longhitoshi2005/Autonomous-Waiter-Robot-Based-on-ROS-2-Jazzy-and-Edge-Computing/ros2_ws/frames_2026-04-19_21.30.28.pdf

view_frames Result

Recorded at time: 1776609028.4618711

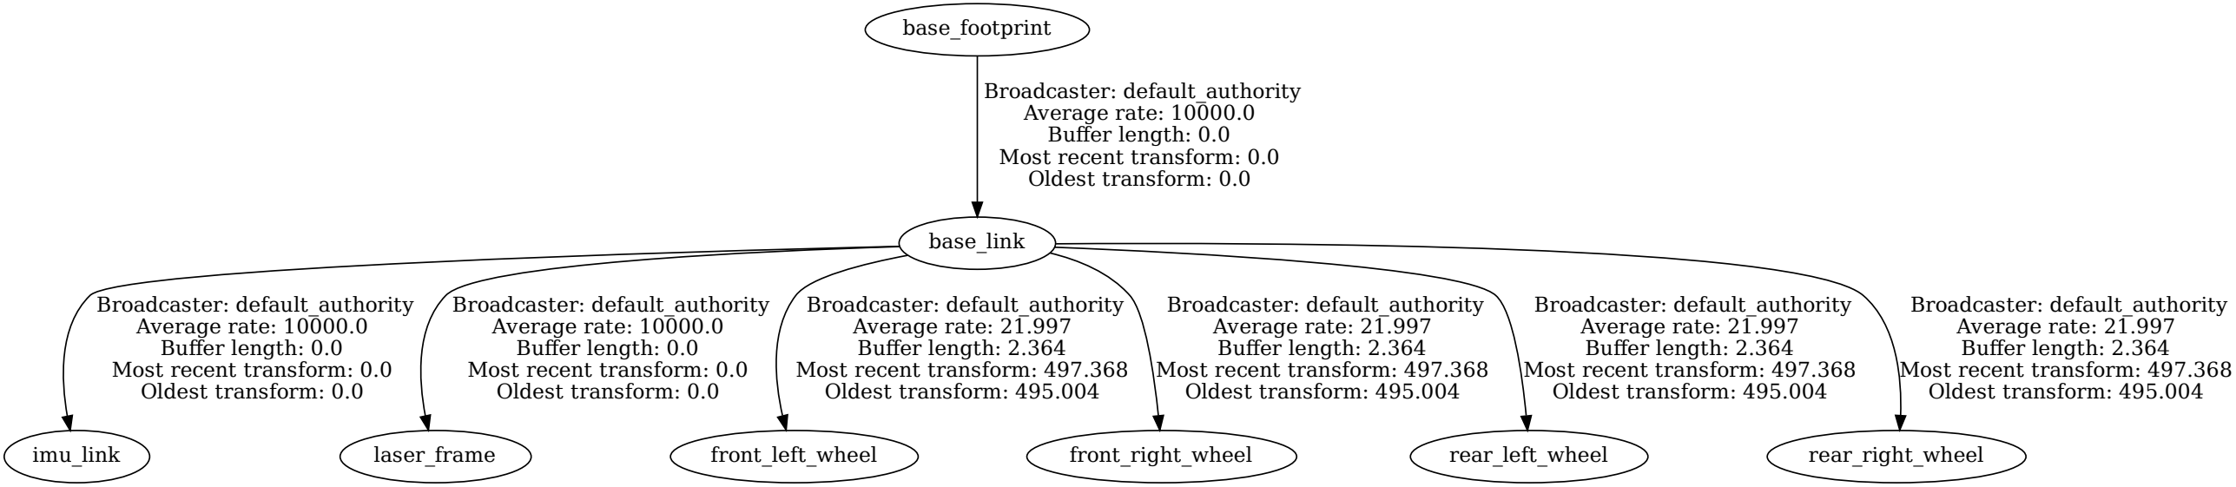
[picture p9: figure]
base_footprint; base_link; Broadcaster: default_authority Average rate: 10000.0 Buffer length: 0.0 Most recent transform: 0.0 Oldest transform: 0.0; imu_link; laser_frame; front_left_wheel; Broadcaster: default_authority Average rate: 21.997 Buffer length: 2.364 Most recent transform: 497.368 Oldest transform: 495.004; front_right_wheel; rear_left_wheel; rear_right_wheel
