longhitoshi2005/Autonomous-Waiter-Robot-Based-on-ROS-2-Jazzy-and-Edge-Computing/Report/z7876923738100_8e52c9ccc1e3791e9a8d2c41e40a2c3e.jpg

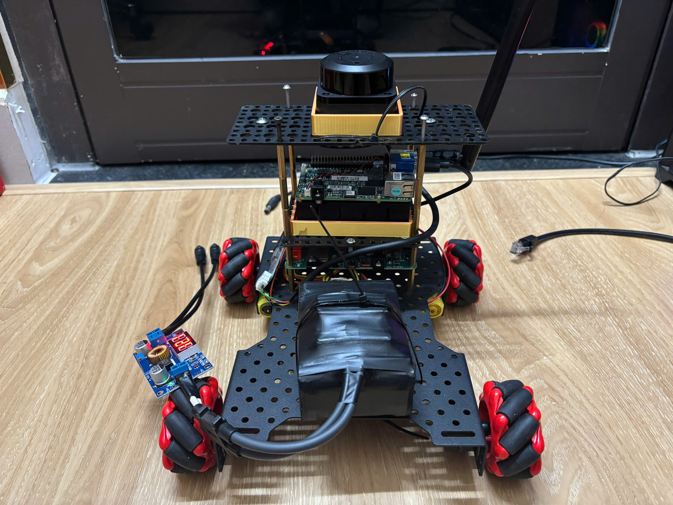
Report/z7876923738100_8e52c9ccc1e3791e9a8d2c41e40a2c3e.jpg
