longhitoshi2005/Autonomous-Waiter-Robot-Based-on-ROS-2-Jazzy-and-Edge-Computing/Report/z7876923738109_6befcf33b369e05750e38895f15ce88e.jpg

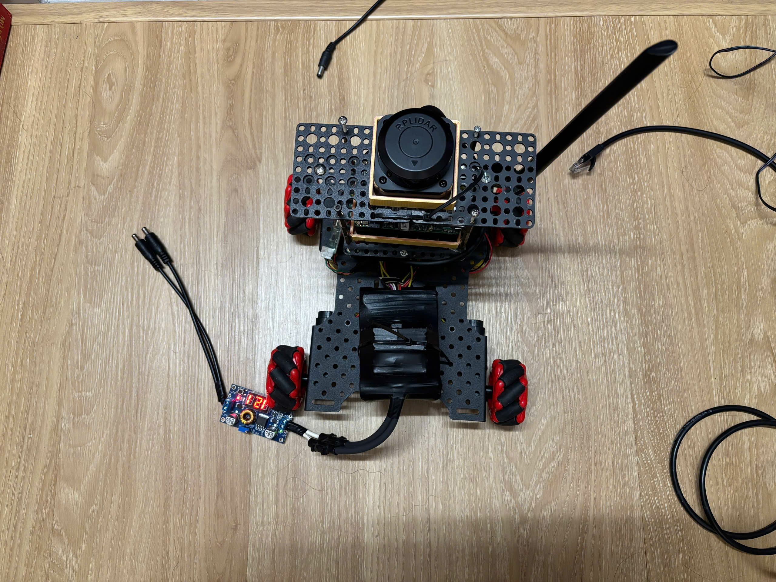
Report/z7876923738109_6befcf33b369e05750e38895f15ce88e.jpg
