longhitoshi2005/Autonomous-Waiter-Robot-Based-on-ROS-2-Jazzy-and-Edge-Computing/Report/z7876923738930_794d4035c0257bd35669a8f1b77754f9.jpg

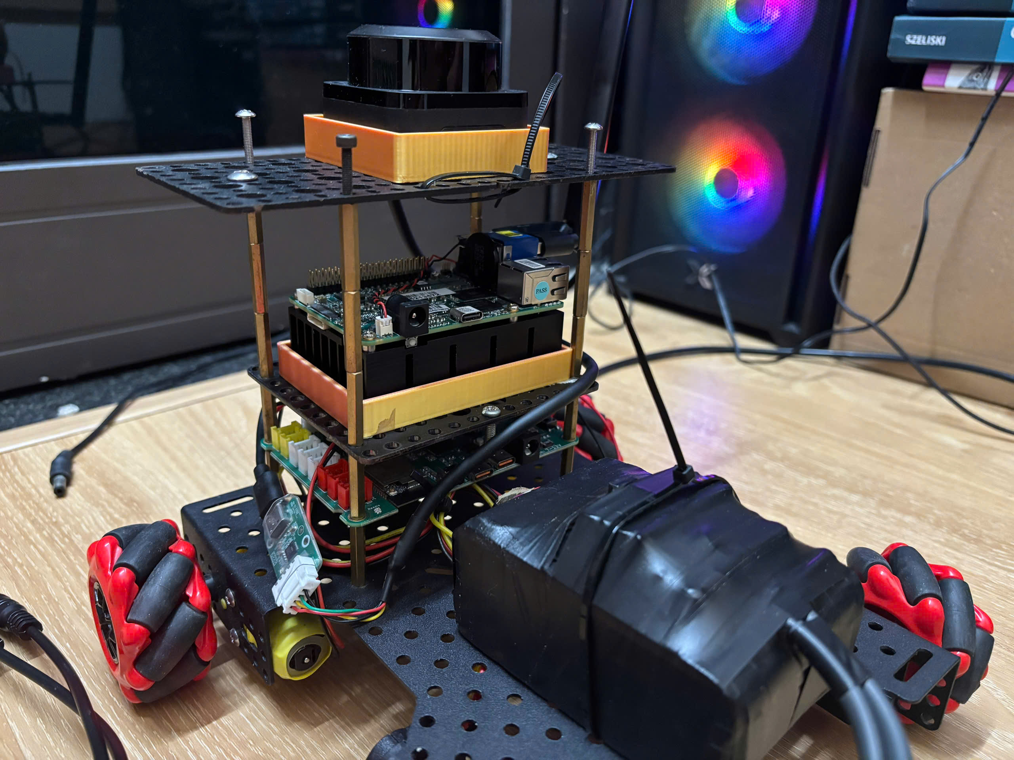
Report/z7876923738930_794d4035c0257bd35669a8f1b77754f9.jpg
