longhitoshi2005/Autonomous-Waiter-Robot-Based-on-ROS-2-Jazzy-and-Edge-Computing/Report/z7876923772007_26db04d665ee63fef783723c3f349a52.jpg

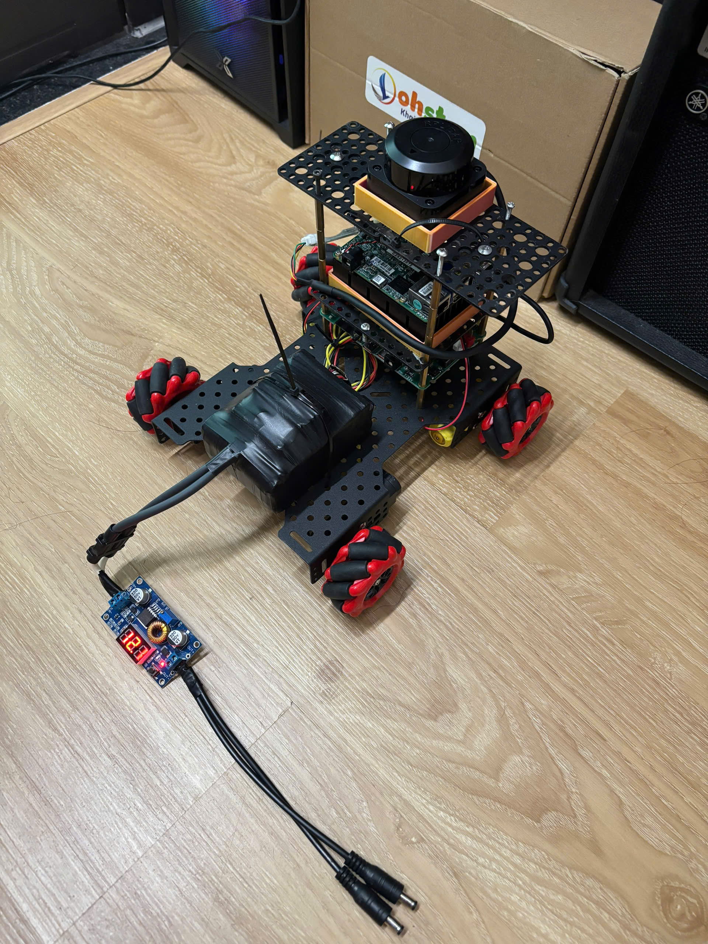
Report/z7876923772007_26db04d665ee63fef783723c3f349a52.jpg
