longhitoshi2005/Autonomous-Waiter-Robot-Based-on-ROS-2-Jazzy-and-Edge-Computing/3Dmodel/Up4000.stl

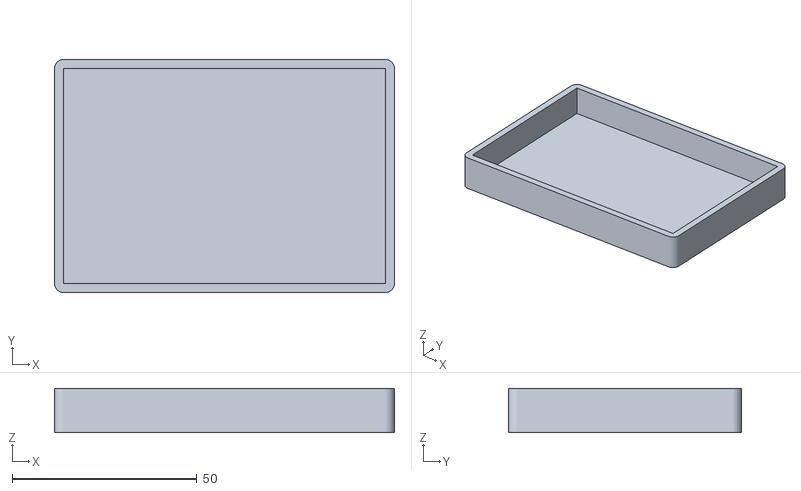
[picture p17: CAD file, 2026-05-29]
3Dmodel/Up4000.stl
91.9 x 63.0 x 12.0
