longhitoshi2005/Autonomous-Waiter-Robot-Based-on-ROS-2-Jazzy-and-Edge-Computing/3Dmodel/lidarC1.stl

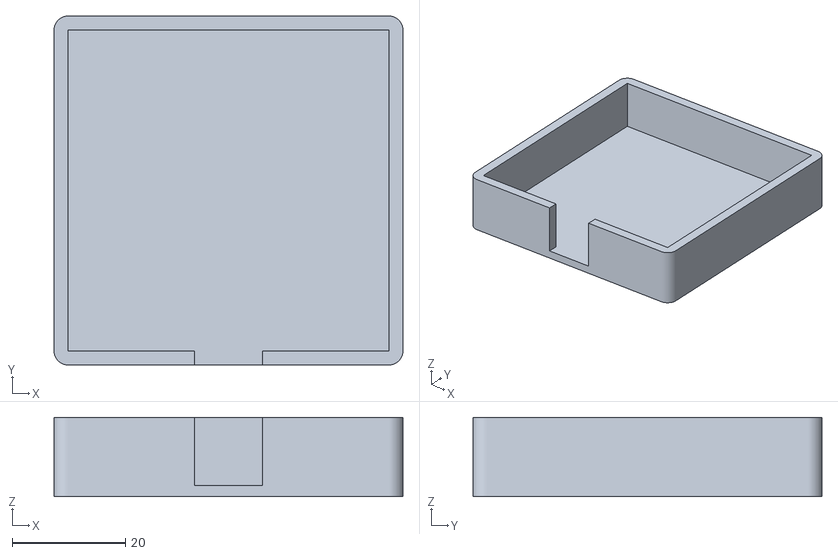
[picture p18: CAD file, 2026-05-29]
3Dmodel/lidarC1.stl
61.6 x 61.6 x 14.0
