longhitoshi2005/Autonomous-Waiter-Robot-Based-on-ROS-2-Jazzy-and-Edge-Computing/Report/frames_2026-05-29_02.35.05.pdf

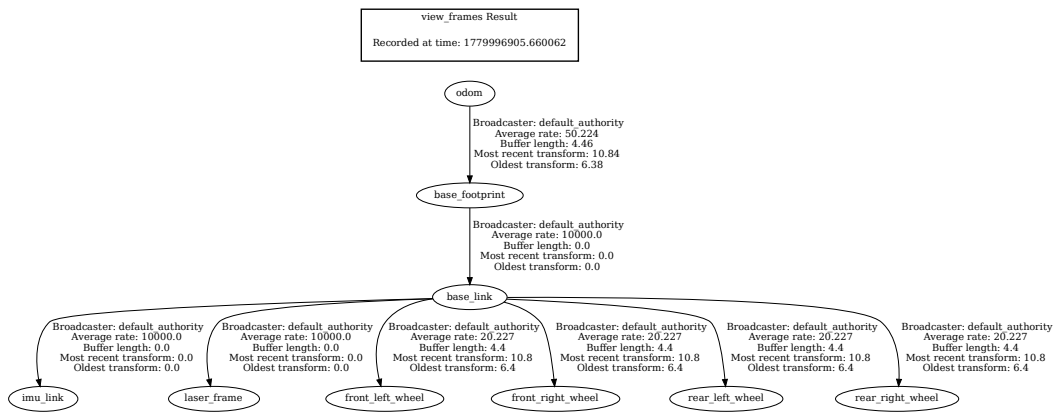
[picture p19: page 1]
view_frames Result; odom; base_footprint; base_link; imu_link; laser_frame; front_left_wheel; front_right_wheel; rear_left_wheel; rear_right_wheel

Recorded at time: 1779996905.660062

Broadcaster: default_authority
Average rate: 50.224
Buffer length: 4.46
Most recent transform: 10.84
Oldest transform: 6.38

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

Average rate: 20.227
Buffer length: 4.4
Most recent transform: 10.8
Oldest transform: 6.4
