longhitoshi2005/Autonomous-Waiter-Robot-Based-on-ROS-2-Jazzy-and-Edge-Computing/ros2_ws/frames_2026-04-19_01.25.27.pdf

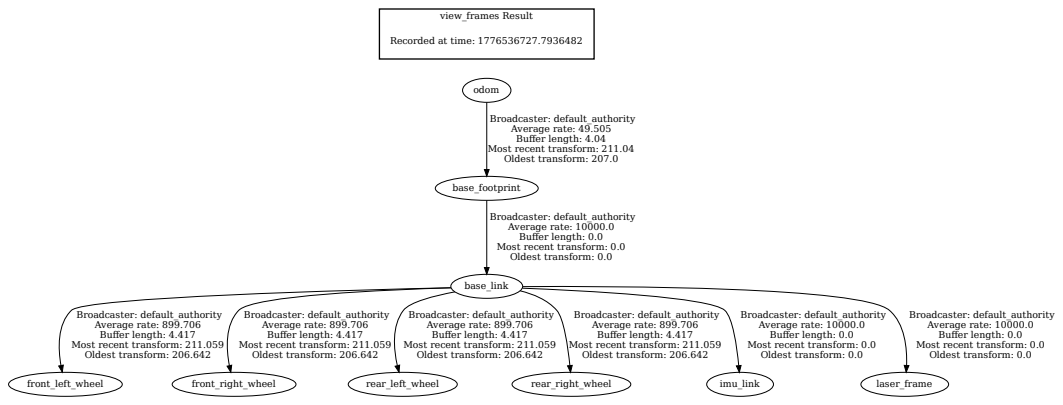
[picture p20: page 1]
view_frames Result; base_link; front_left_wheel; front_right_wheel; rear_left_wheel; rear_right_wheel; imu_link; laser_frame; base_footprint; odom

Recorded at time: 1776536727.7936482

Broadcaster: default_authority
Average rate: 49.505
Buffer length: 4.04
Most recent transform: 211.04
Oldest transform: 207.0

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

Average rate: 899.706
Buffer length: 4.417
Most recent transform: 211.059
Oldest transform: 206.642
