longhitoshi2005/Autonomous-Waiter-Robot-Based-on-ROS-2-Jazzy-and-Edge-Computing/(commit log)

2026-05-29 Initial ROS 2 workspace commit
    [roboco.urdf.xacro, room_20m2.sdf]
2026-05-29 Track full DADN project structure
    [Up4000.scad, Up4000.stl, lidarC1.stl, roboco.urdf.xacro, room_20m2.sdf]
